mnemocron/Nucleo-DSP-Shield/README.md

# Nucleo-DSP-Shield
Audio DSP Shield for STM32 Nucleo-144 Boards (H723zg) based on the TLV320 CODEC

---

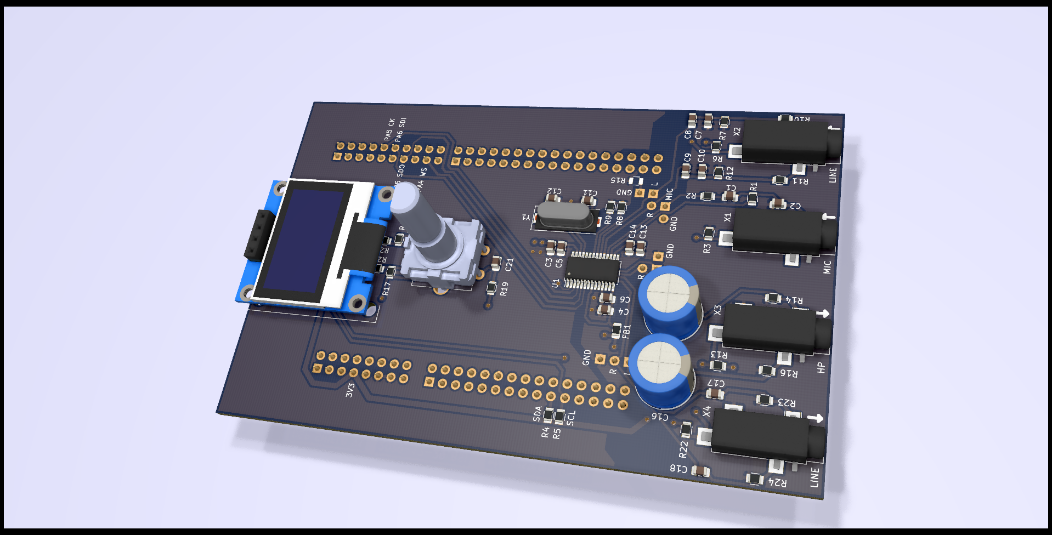
[picture p1: img/kicad3d.png]
