mnemocron/Nucleo-DSP-Shield/Nucleo144_DSP.kicad_pcb

## KiCad design Nucleo144_DSP.kicad_pcb (2021-01-03)

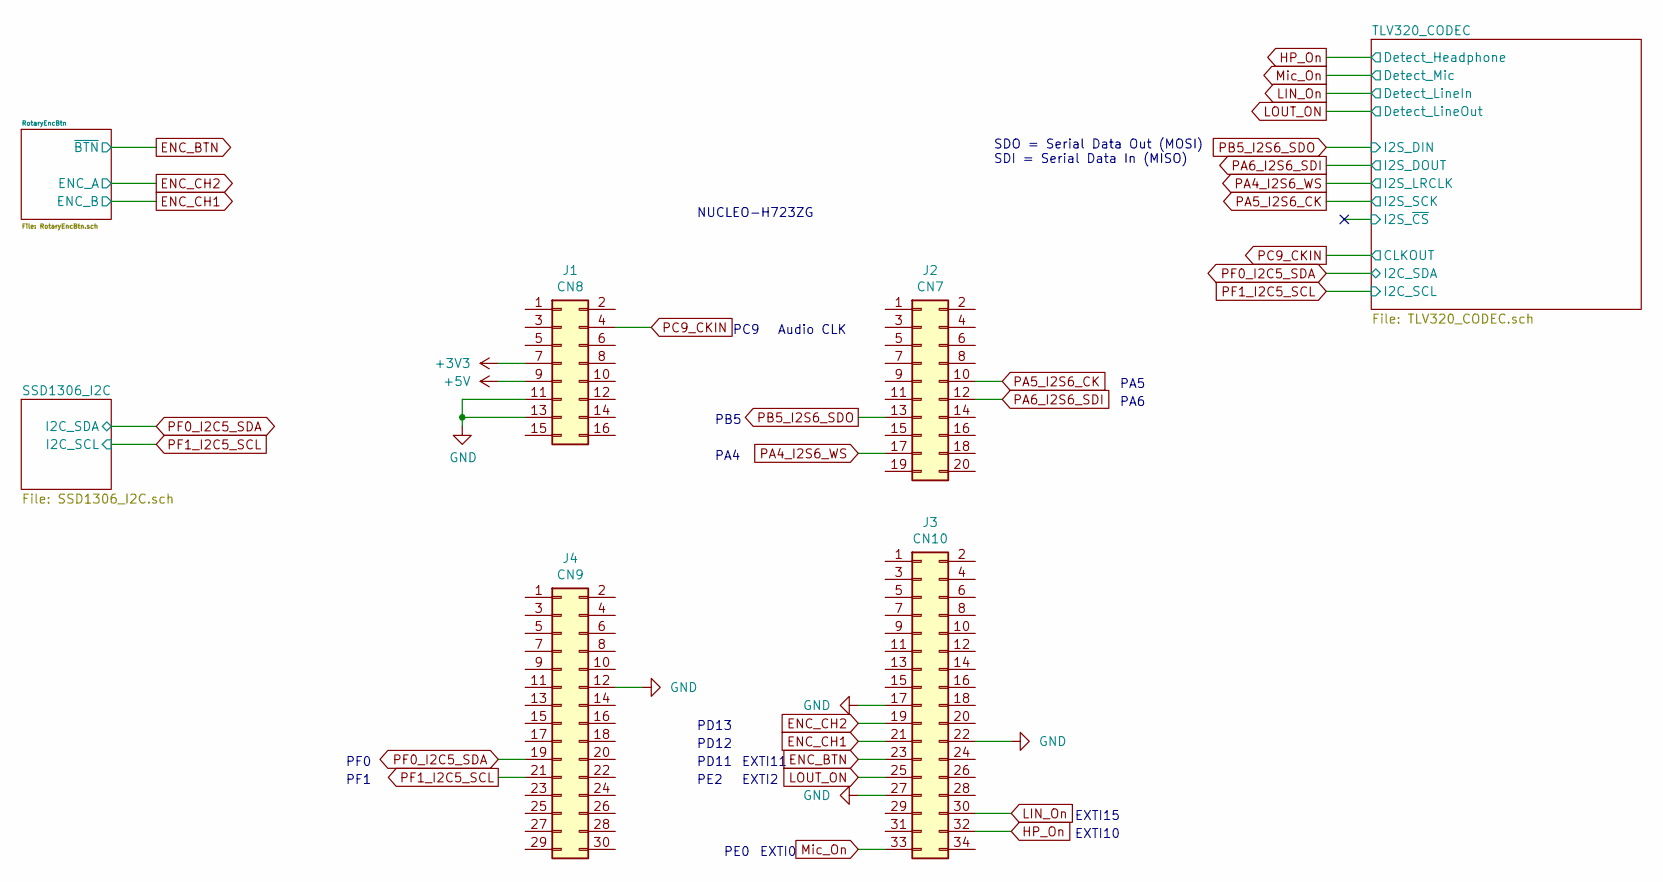
[picture p2: schematic Nucleo144_DSP.sch]

Parts:
J1: CN8; PinSocket_2x08_P2.54mm_Vertical; JLCPCB do not place
J2: CN7; PinSocket_2x10_P2.54mm_Vertical; JLCPCB do not place
J3: CN10; PinSocket_2x17_P2.54mm_Vertical; JLCPCB do not place
J4: CN9; PinSocket_2x15_P2.54mm_Vertical; JLCPCB do not place

Connections:
+5V: J1.9
ENC_BTN: J3.23; also elsewhere on the board
ENC_CH1: J3.21; also elsewhere on the board
ENC_CH2: J3.19; also elsewhere on the board
GND: J1.11, J1.13, J3.17, J3.22, J3.27, J4.12; also elsewhere on the board
HP_On: J3.32; also elsewhere on the board
LIN_On: J3.30; also elsewhere on the board
LOUT_ON: J3.25; also elsewhere on the board
Mic_On: J3.33; also elsewhere on the board
PA4_I2S6_WS: J2.17; also elsewhere on the board
PA5_I2S6_CK: J2.10; also elsewhere on the board
PA6_I2S6_SDI: J2.12; also elsewhere on the board
PB5_I2S6_SDO: J2.13; also elsewhere on the board
PC9_CKIN: J1.4; also elsewhere on the board
PF0_I2C5_SDA: J4.19; also elsewhere on the board
PF1_I2C5_SCL: J4.21; also elsewhere on the board

Notes on the sheet:
NUCLEO-H723ZG
EXTI0
EXTI10
EXTI11
EXTI2
EXTI15
PE0
PE2
PD11
PD12
PD13
PA4
PB5
PA6
PA5
SDO = Serial Data Out (MOSI) SDI = Serial Data In (MISO)
PF1
PF0
PC9
Audio CLK

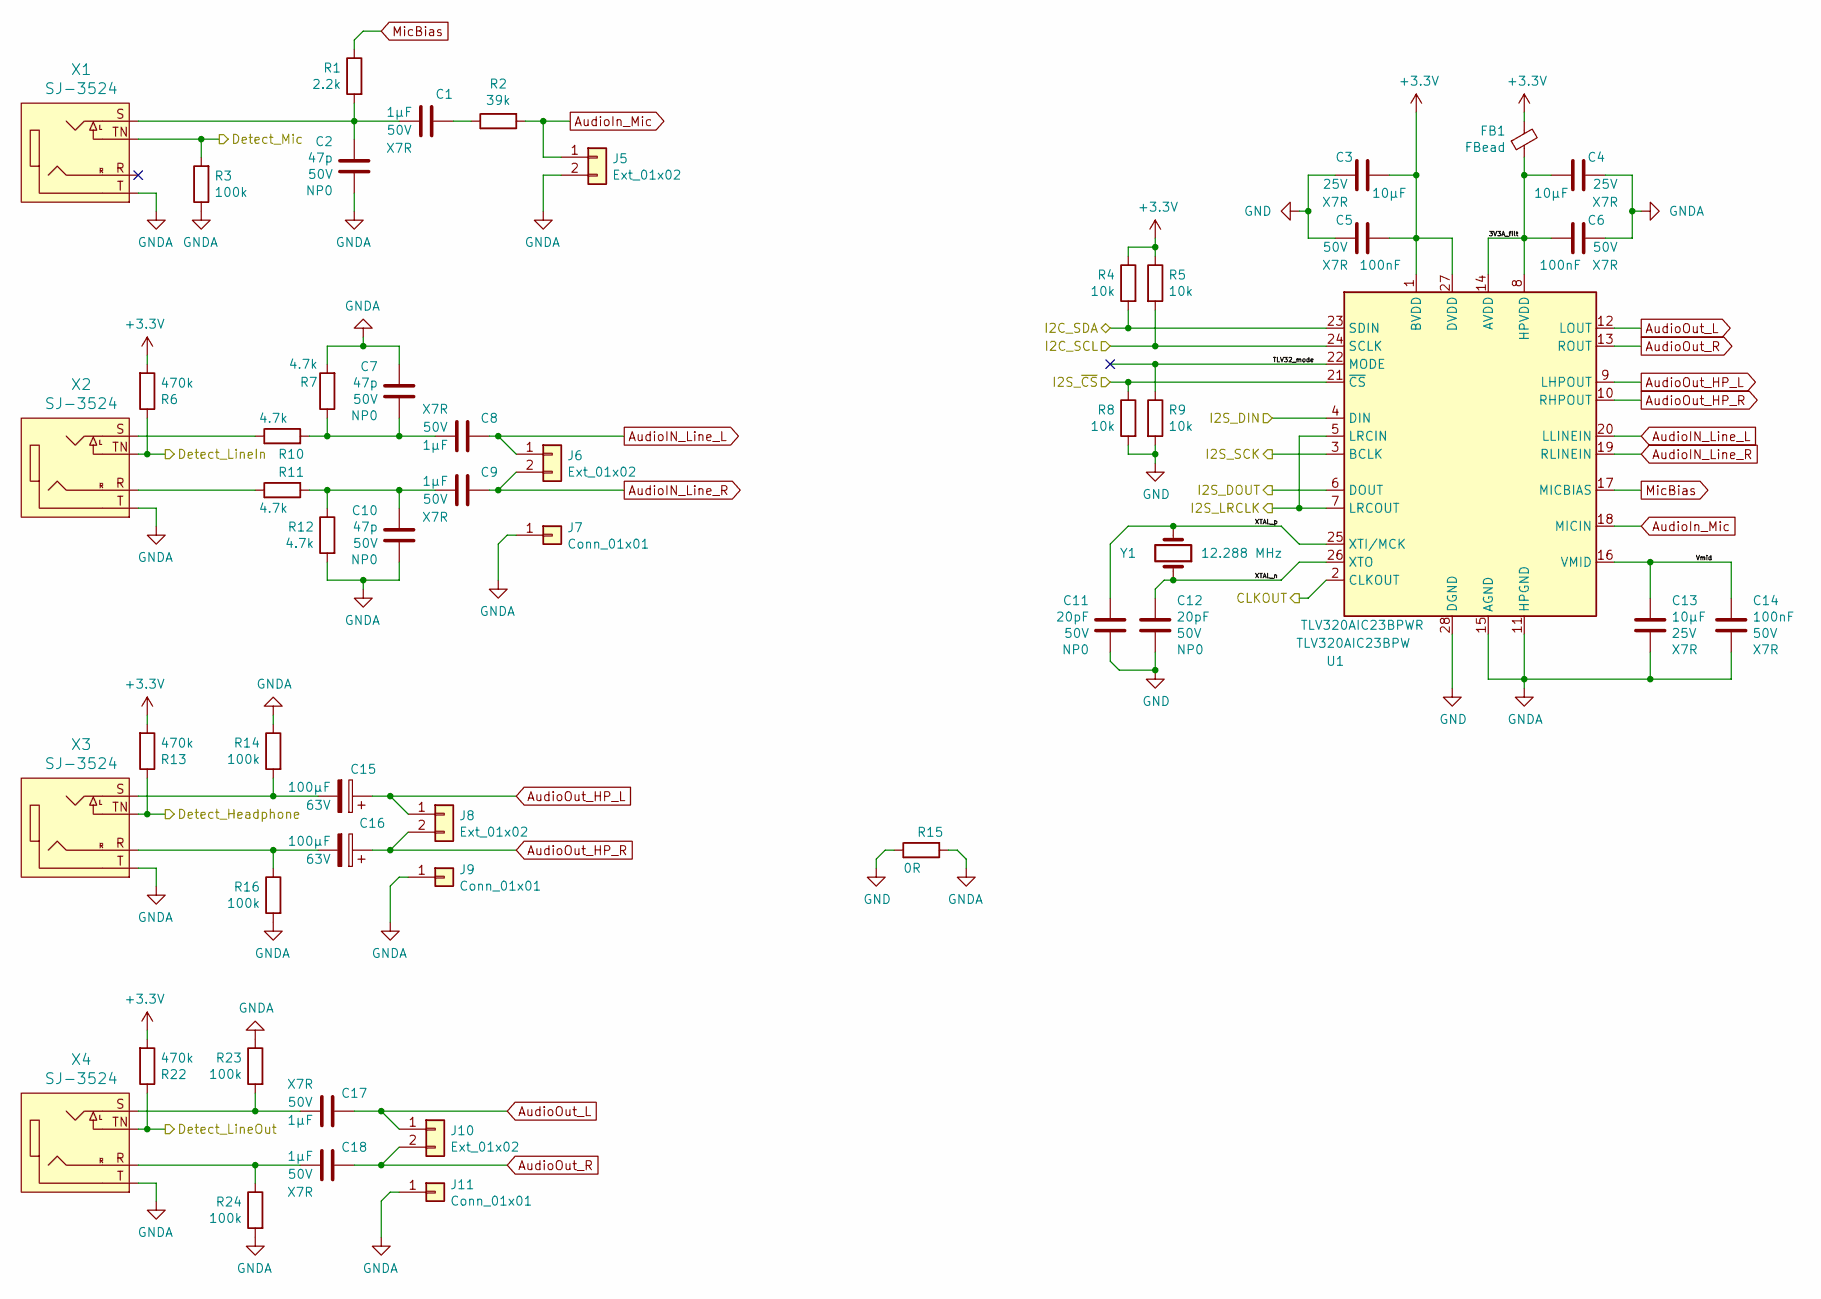
[picture p3: schematic TLV320_CODEC.sch]

Parts:
C1, C8, C9, C17, C18: 1μF; C_0805_2012Metric; Voltage 50V; JLCPCB Basic Part
C2, C7, C10: 47p; C_0805_2012Metric; Voltage 50V; JLCPCB Basic Part
C3, C4, C13: 10μF; C_0805_2012Metric; Voltage 25V; JLCPCB Basic Part
C5, C6, C14: 100nF; C_0805_2012Metric; Voltage 50V; JLCPCB Basic Part
C11, C12: 20pF; C_0805_2012Metric; Voltage 50V; JLCPCB Basic Part
C15, C16: 100μF; CP_Radial_D10.0mm_P5.00mm; Voltage 63V; JLCPCB do not place
FB1: FBead; R_0805_2012Metric; JLCPCB do not place
J5, J6, J8, J10: Ext_01x02; PinSocket_1x02_P2.54mm_Vertical; JLCPCB do not place
J7, J9, J11: Conn_01x01; PinSocket_1x01_P2.54mm_Vertical; JLCPCB do not place
R1: 2.2k; R_0805; Tolerance 1%; JLCPCB Basic Part
R2: 39k; R_0805; Tolerance 1%; JLCPCB Basic Part
R3, R14, R16, R23, R24: 100k; R_0805; Tolerance 1%; JLCPCB Basic Part
R4, R5, R8, R9: 10k; R_0805; Tolerance 1%; JLCPCB Basic Part
R6, R13, R22: 470k; R_0805; Tolerance 1%; JLCPCB Basic Part
R7, R10, R11, R12: 4.7k; R_0805; Tolerance 1%; JLCPCB Basic Part
R15: 0R; R_0805; Tolerance 1%; JLCPCB Basic Part
U1: TLV320AIC23BPW; TSSOP-28_4.4x9.7mm_P0.65mm; JLCPCB Extended Part
X1, X2, X3, X4: SJ-3524; Jack_3.5mm_CUI_SJ-3524-SMT_Horizontal; JLCPCB do not place
Y1: 12.288 MHz; Crystal_SMD_HC49-SD; JLCPCB Extended Part

Connections:
/TLV320_CODEC/3V3A_filt: C4.2, C6.2, FB1.1, U1.8 (HPVDD), U1.14 (AVDD)
/TLV320_CODEC/I2S_~CS~: R8.1, U1.21 (~CS~)
/TLV320_CODEC/TLV32_mode: R9.1, U1.22 (MODE)
/TLV320_CODEC/Vmid: C13.1, C14.1, U1.16 (VMID)
/TLV320_CODEC/XTAL_n: C12.2, U1.26 (XTO), Y1.1
/TLV320_CODEC/XTAL_p: C11.2, U1.25 (XTI/MCK), Y1.2
AudioIN_Line_L: C8.2, J6.1, U1.20 (LLINEIN)
AudioIN_Line_R: C9.2, J6.2, U1.19 (RLINEIN)
AudioIn_Mic: J5.1, R2.2, U1.18 (MICIN)
AudioOut_HP_L: C15.1, J8.1, U1.9 (LHPOUT)
AudioOut_HP_R: C16.1, J8.2, U1.10 (RHPOUT)
AudioOut_L: C17.2, J10.1, U1.12 (LOUT)
AudioOut_R: C18.2, J10.2, U1.13 (ROUT)
GND: C3.1, C5.1, C11.1, C12.1, R8.2, R9.2, R15.1, U1.28 (DGND); also elsewhere on the board
GNDA: C2.2, C4.1, C6.1, C7.1, C10.2, C13.2, C14.2, J5.2, J7.1, J9.1, J11.1, R3.1, R7.2, R12.2, R14.1, R15.2, R16.2, R23.1, R24.2, U1.11 (HPGND), U1.15 (AGND), X1.T, X2.T, X3.T, X4.T
HP_On: R13.1, X3.TN; also elsewhere on the board
LIN_On: R6.1, X2.TN; also elsewhere on the board
LOUT_ON: R22.1, X4.TN; also elsewhere on the board
MicBias: R1.1, U1.17 (MICBIAS)
Mic_On: R3.2, X1.TN; also elsewhere on the board
unnamed: C1.1, C2.1, R1.2, X1.S
unnamed: C1.2, R2.1
unnamed: C7.2, C8.1, R7.1, R10.2
unnamed: C9.1, C10.1, R11.2, R12.1
unnamed: C15.2, R14.2, X3.S
unnamed: C16.2, R16.1, X3.R
unnamed: C17.1, R23.2, X4.S
unnamed: C18.1, R24.1, X4.R
unnamed: R10.1, X2.S
unnamed: R11.1, X2.R
PA4_I2S6_WS: U1.5 (LRCIN), U1.7 (LRCOUT); also elsewhere on the board
PA5_I2S6_CK: U1.3 (BCLK); also elsewhere on the board
PA6_I2S6_SDI: U1.6 (DOUT); also elsewhere on the board
PB5_I2S6_SDO: U1.4 (DIN); also elsewhere on the board
PC9_CKIN: U1.2 (CLKOUT); also elsewhere on the board
PF0_I2C5_SDA: R4.2, U1.23 (SDIN); also elsewhere on the board
PF1_I2C5_SCL: R5.2, U1.24 (SCLK); also elsewhere on the board

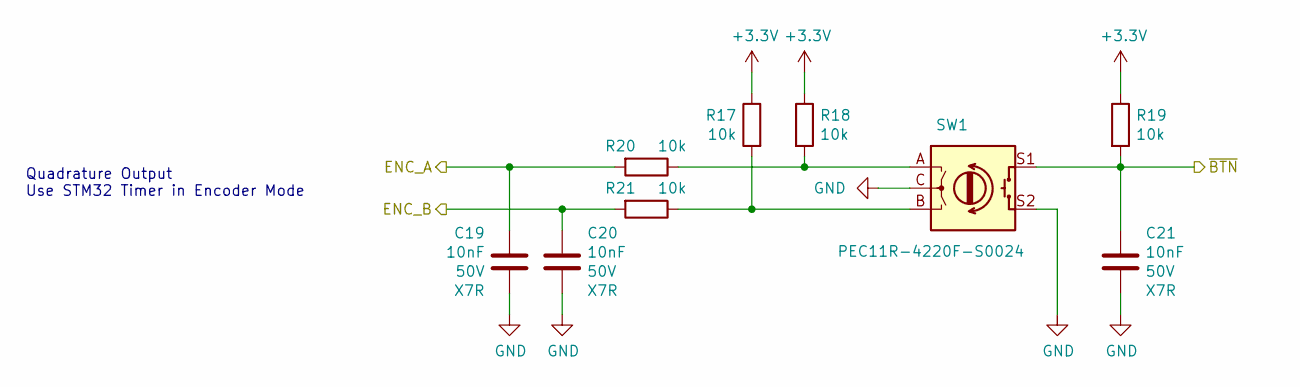
[picture p4: schematic RotaryEncBtn.sch]

Parts:
C19, C20, C21: 10nF; C_0805_2012Metric; Voltage 50V; JLCPCB Basic Part
R17, R18, R19, R20, R21: 10k; R_0805; Tolerance 1%; JLCPCB Basic Part
SW1: PEC11R-4220F-S0024; RotaryEncoder_Alps_EC11E-Switch_Vertical_H20mm_CircularMoun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; JLCPCB do not place

Connections:
ENC_BTN: C21.1, R19.2, SW1.S1; also elsewhere on the board
ENC_CH1: C20.1, R21.2; also elsewhere on the board
ENC_CH2: C19.2, R20.2; also elsewhere on the board
GND: C19.1, C20.2, C21.2, SW1.C, SW1.S2; also elsewhere on the board
unnamed: R17.2, R21.1, SW1.B
unnamed: R18.2, R20.1, SW1.A

Notes on the sheet:
Quadrature Output Use STM32 Timer in Encoder Mode

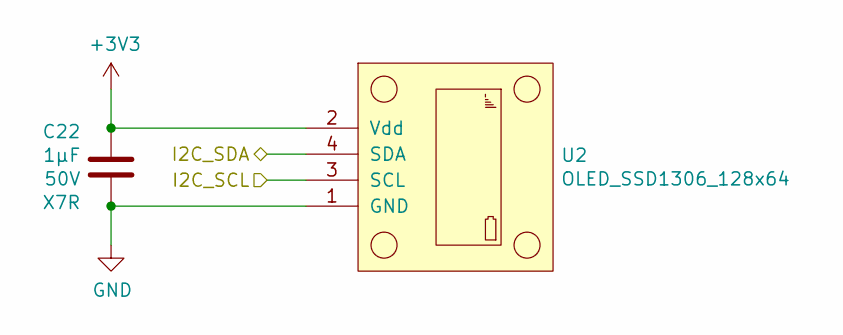
[picture p5: schematic SSD1306_I2C.sch]

Parts:
C22: 1μF; C_0805_2012Metric; Voltage 50V; JLCPCB Basic Part
U2: OLED_SSD1306_128x64; PinSocket_1x04_P2.54mm_Vertical; JLCPCB do not place

Connections:
GND: C22.1, U2.1 (GND); also elsewhere on the board
PF0_I2C5_SDA: U2.4 (SDA); also elsewhere on the board
PF1_I2C5_SCL: U2.3 (SCL); also elsewhere on the board

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
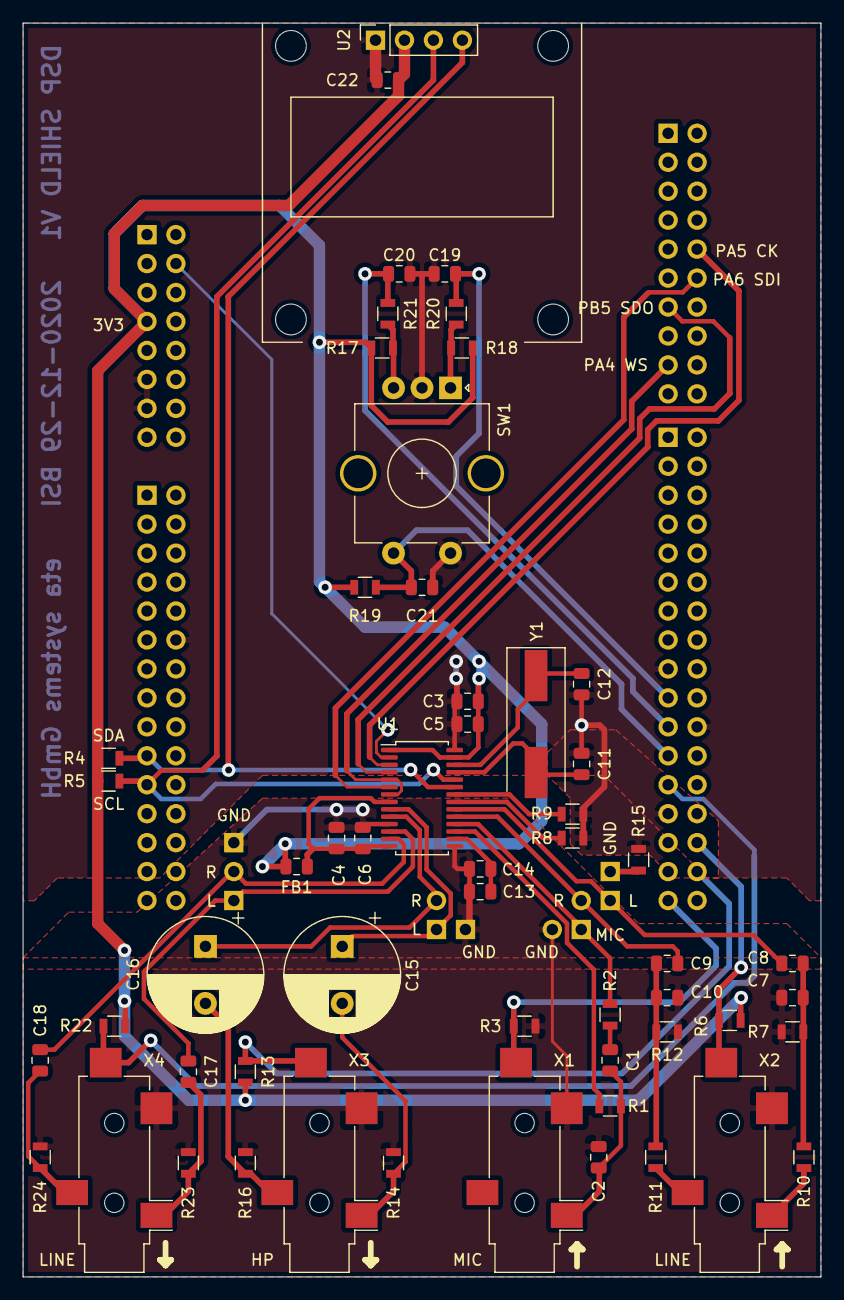
[picture p6: board Nucleo144_DSP.kicad_pcb from above]

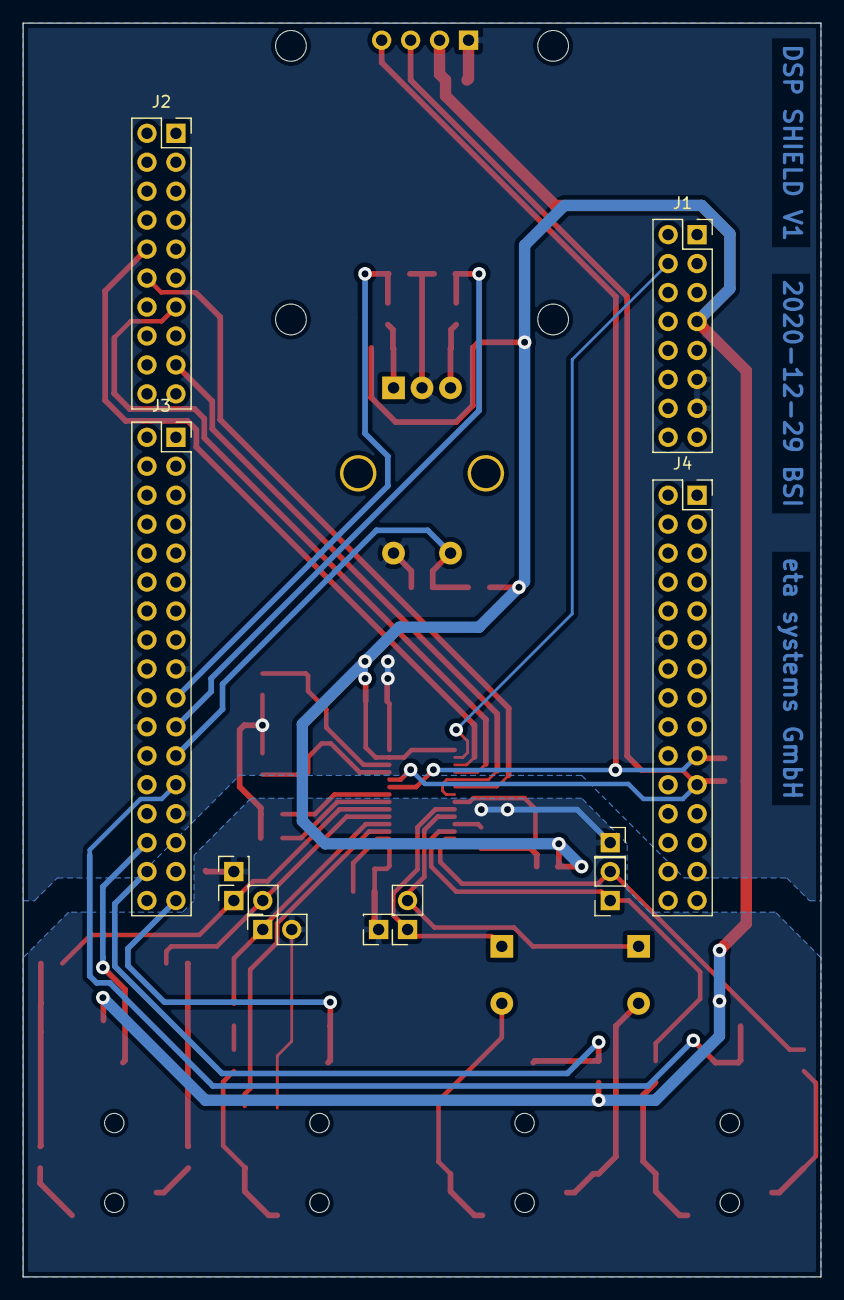
[picture p7: board Nucleo144_DSP.kicad_pcb from below]

Board: 2 copper layers, 70.0 x 110.0 mm, 66 parts (11 on the bottom side), 43 nets.
